FlukeyLukey77/ArduinoLEDClock/Clock Concept render.PNG

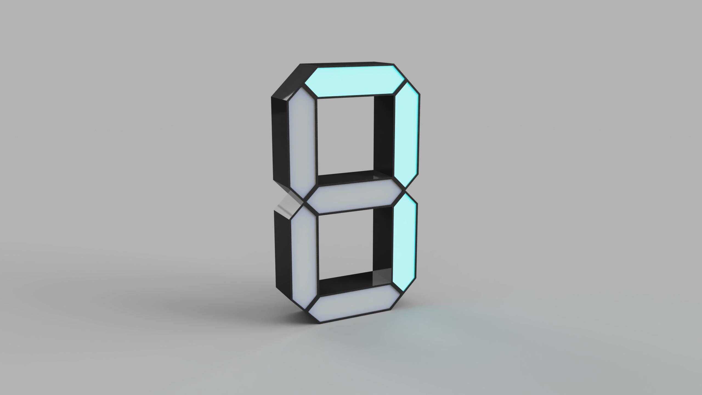
Clock Concept render.PNG
