FlukeyLukey77/ArduinoLEDClock/STLs/SegmentMain.stl

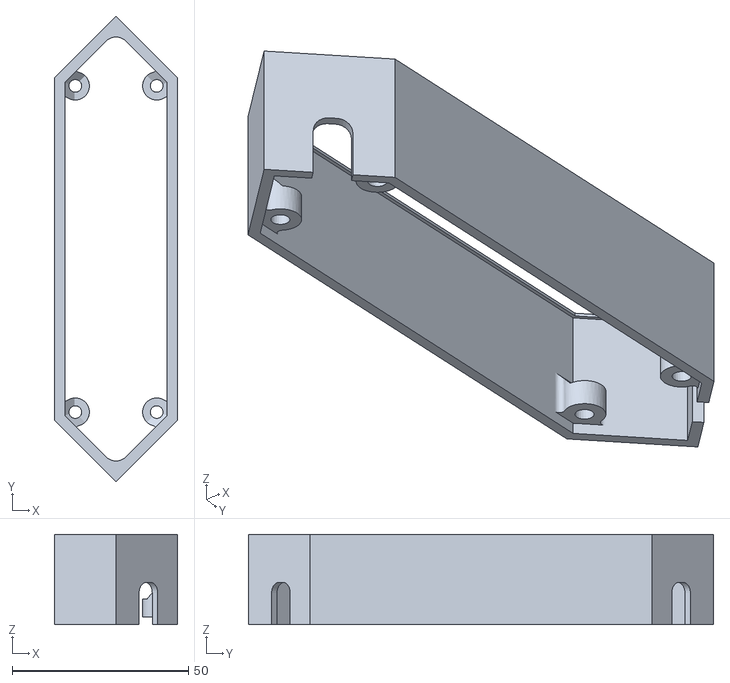
[picture p2: CAD file, 2021-03-03]
STLs/SegmentMain.stl
35.0 x 132.1 x 25.6
