FlukeyLukey77/ArduinoLEDClock/ArduinoLEDClock.step

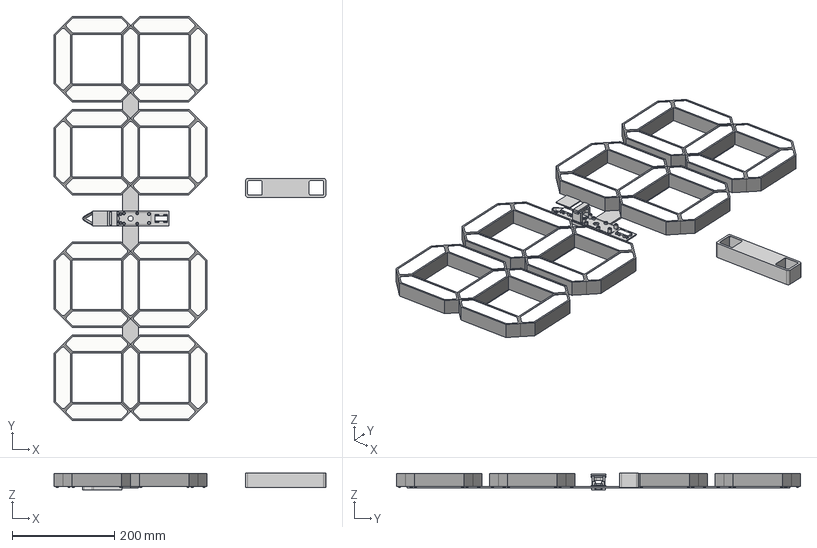
[picture p3: CAD file, 2021-03-03]
ArduinoLEDClock.step
531.9 x 791.2 x 32.4 mm
Back Plate x 24
Main Body x 24
Lens x 24
PCB (1) x 16
5050 RBG LED (1) x 48
Resistor (1) x 48
PCB (2) x 16
5050 RBG LED (2) x 48
Resistor (2) x 48
Aluminium LED Support x 24
Threaded Insert x 96
94500A262 x 96
Back Plate (1) x 4
Main Body (1) x 4
Lens (1) x 4
PCB (1) (1) x 4
5050 RBG LED (1) (1) x 12
Resistor (1) (1) x 12
PCB (2) (1) x 4
5050 RBG LED (2) (1) x 12
Resistor (2) (1) x 12
Aluminium LED Support (1) x 4
Threaded Insert (1) x 16
94500A262 (1) x 16
Steel Support
Aluminium x 2
Magnet x 2
Lens (2)
Centre Cover
Mouting hook
