FlukeyLukey77/ArduinoLEDClock/Clock PCB V2/Clock PCB.step

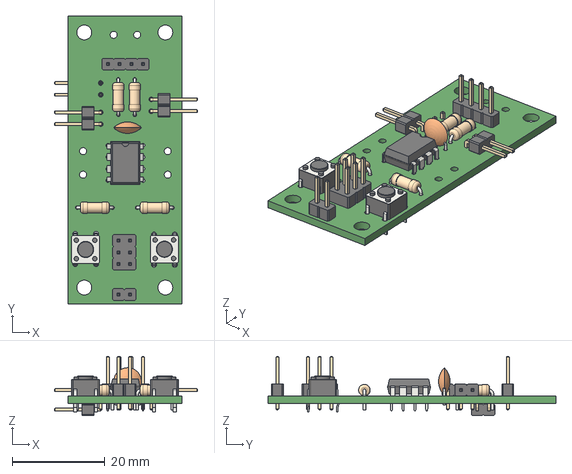
[picture p4: CAD file, 2021-03-03]
Clock PCB V2/Clock PCB.step
31.0 x 62.2 x 12.8 mm
