FlukeyLukey77/ArduinoLEDClock/STLs/CentreWallHook.stl

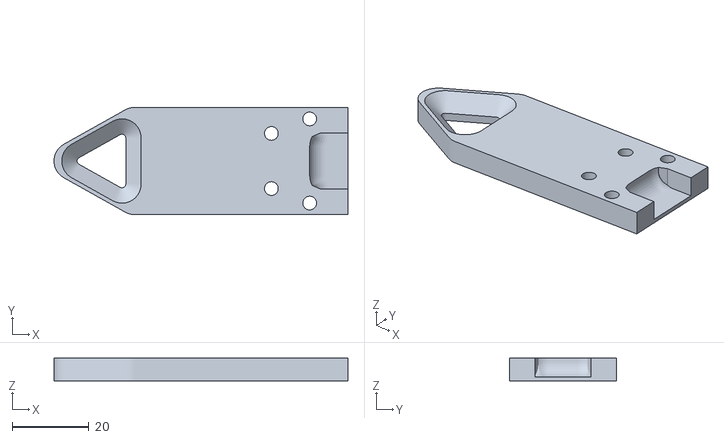
[picture p5: CAD file, 2021-03-03]
STLs/CentreWallHook.stl
76.8 x 28.0 x 6.00
