FlukeyLukey77/ArduinoLEDClock/STLs/SegmentLens.stl

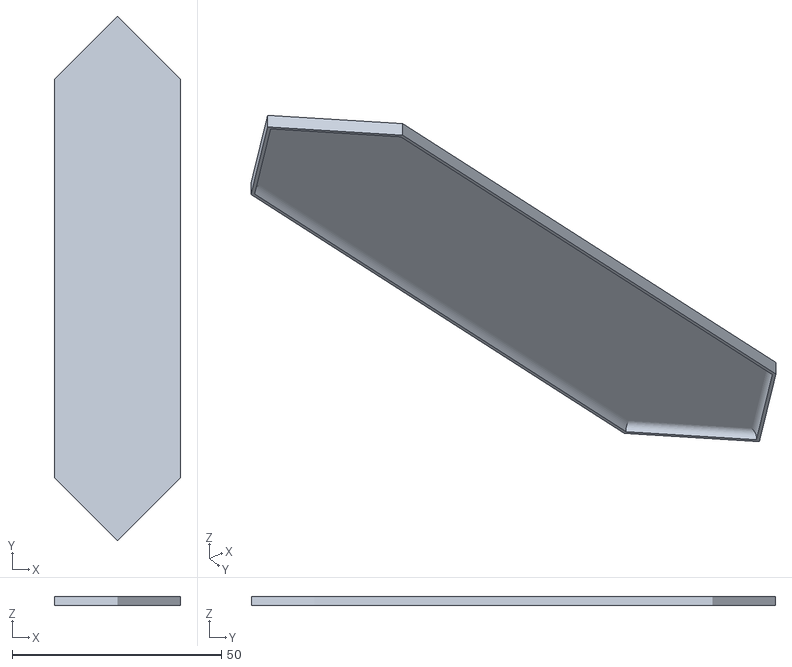
[picture p6: CAD file, 2021-03-03]
STLs/SegmentLens.stl
30.2 x 125.3 x 2.10
