FlukeyLukey77/ArduinoLEDClock/STLs/CentreCover.stl

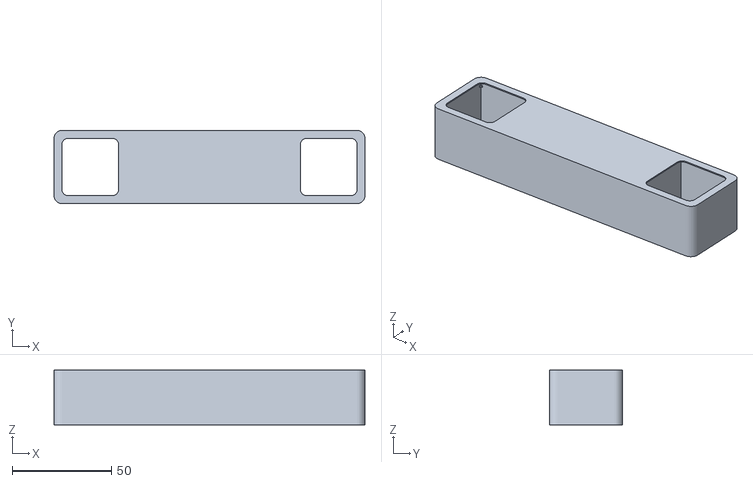
[picture p7: CAD file, 2021-03-03]
STLs/CentreCover.stl
157.0 x 37.0 x 27.6
