FlukeyLukey77/ArduinoLEDClock/STLs/CentreLens.stl

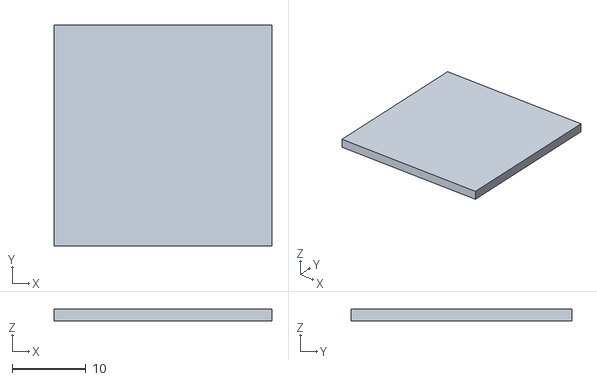
[picture p8: CAD file, 2021-03-03]
STLs/CentreLens.stl
29.6 x 30.0 x 1.60
