FlukeyLukey77/ArduinoLEDClock/STLs/CentreBack.stl

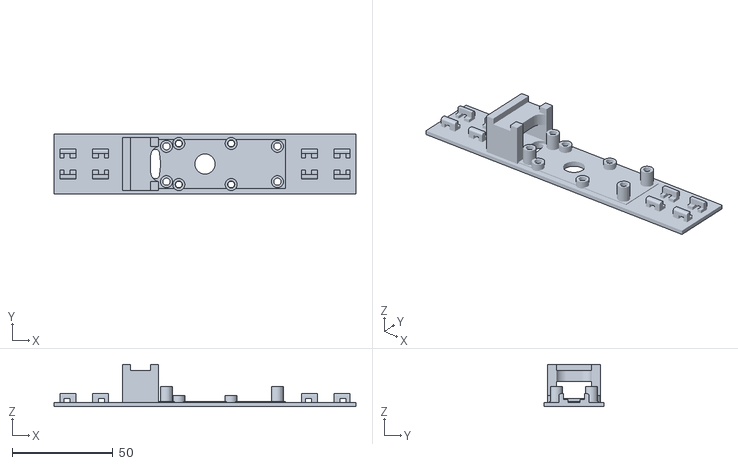
[picture p9: CAD file, 2021-03-03]
STLs/CentreBack.stl
150.0 x 30.0 x 21.1
