FlukeyLukey77/ArduinoLEDClock/STLs/SegementBack.stl

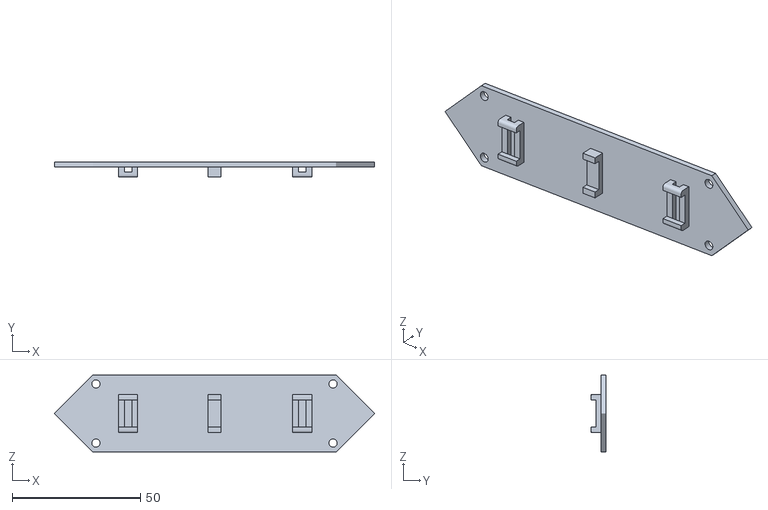
[picture p10: CAD file, 2021-03-03]
STLs/SegementBack.stl
125.0 x 6.00 x 30.0
