FlukeyLukey77/ArduinoLEDClock/Clock PCB/Clock PCB.kicad_pcb

## KiCad design Clock PCB/Clock PCB.kicad_pcb (2021-03-03)

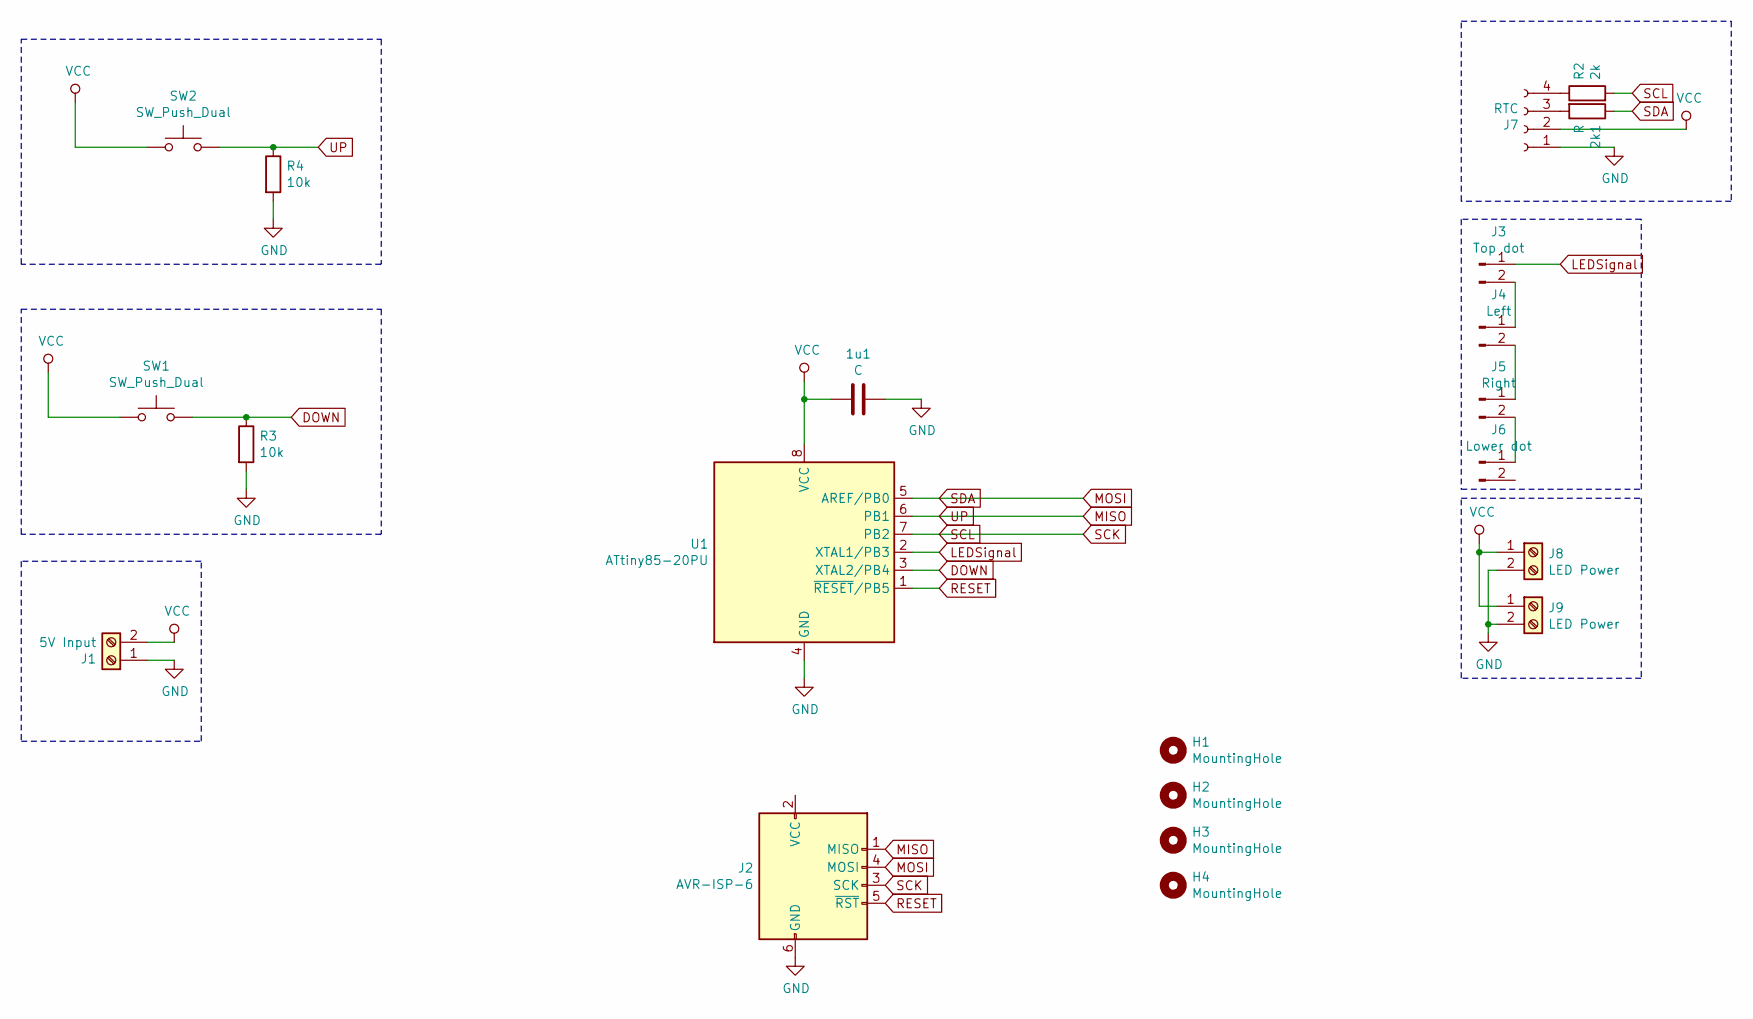
[picture p11: schematic Clock PCB.sch]

Parts:
1u1: C; C_Disc_D6.0mm_W2.5mm_P5.00mm
2k1: R; R_Axial_DIN0207_L6.3mm_D2.5mm_P7.62mm_Horizontal
H1, H2, H3, H4: MountingHole; MountingHole_3.2mm_M3
J1: 5V Input; TerminalBlock_bornier-2_P5.08mm
J2: AVR-ISP-6; PinHeader_2x03_P2.54mm_Vertical
J3: Top dot; PinHeader_1x02_P2.54mm_Horizontal
J4: Left; PinHeader_1x02_P2.54mm_Horizontal
J5: Right; PinHeader_1x02_P2.54mm_Horizontal
J6: Lower dot; PinHeader_1x02_P2.54mm_Vertical
J7: RTC; PinHeader_1x04_P2.54mm_Vertical
J8, J9: LED Power; TerminalBlock_bornier-2_P5.08mm
R2: 2k; R_Axial_DIN0207_L6.3mm_D2.5mm_P7.62mm_Horizontal
R3, R4: 10k; R_Axial_DIN0207_L6.3mm_D2.5mm_P7.62mm_Horizontal
SW1, SW2: SW_Push_Dual; SW_PUSH_6mm_H4.3mm
U1: ATtiny85-20PU; DIP-8_W7.62mm

Connections:
DOWN: R3.1, SW1.2, U1.3 (XTAL2/PB4)
GND: 1u1.1, J1.1, J2.6 (GND), J7.1, J8.2, J9.2, R3.2, R4.2, U1.4 (GND)
LEDSignal: J3.1, U1.2 (XTAL1/PB3)
MISO: J2.1 (MISO), R4.1, SW2.2, U1.6 (PB1)
MOSI: 2k1.1, J2.4 (MOSI), U1.5 (AREF/PB0)
unnamed: 2k1.2, J7.3
unnamed: J3.2, J4.1
unnamed: J4.2, J5.1
unnamed: J5.2, J6.1
unnamed: J7.4, R2.1
RESET: J2.5 (~RST), U1.1 (~RESET~/PB5)
SCK: J2.3 (SCK), R2.2, U1.7 (PB2)
VCC: 1u1.2, J1.2, J7.2, J8.1, J9.1, SW1.1, SW2.1, U1.8 (VCC)

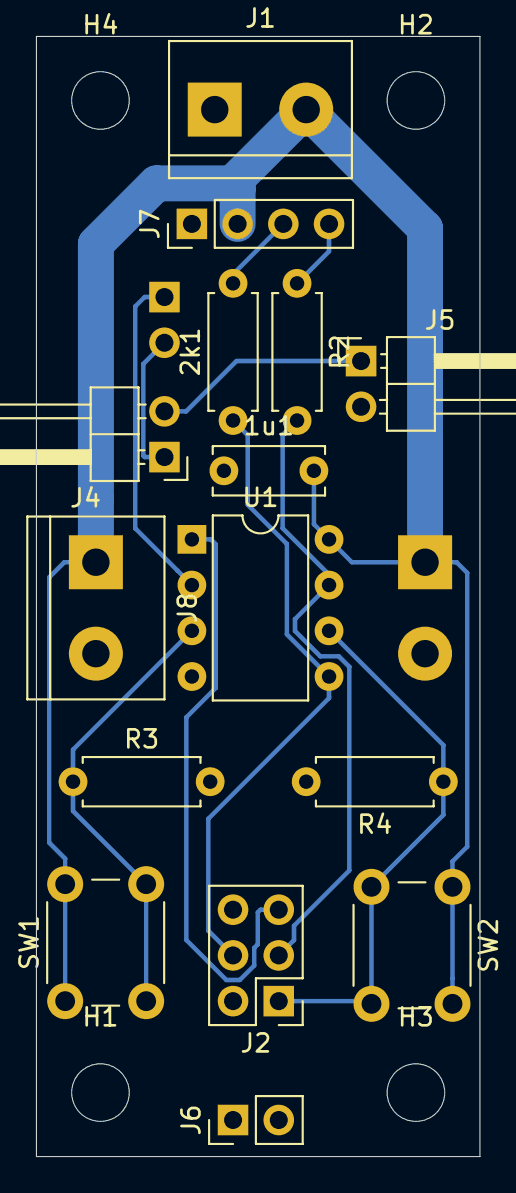
[picture p12: board Clock PCB/Clock PCB.kicad_pcb from above]

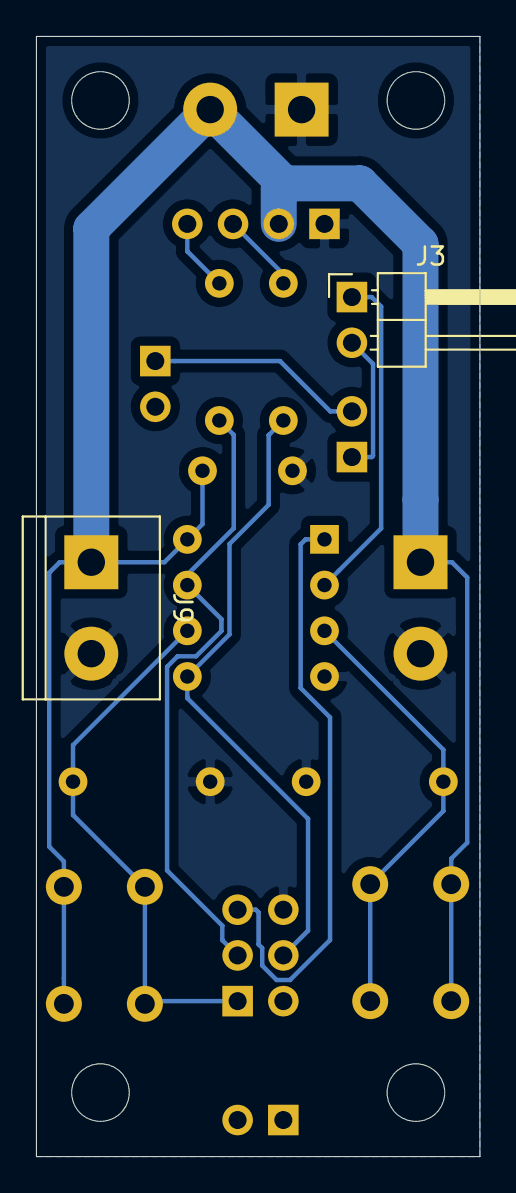
[picture p13: board Clock PCB/Clock PCB.kicad_pcb from below]

Board: 2 copper layers, 24.6 x 62.2 mm, 21 parts (2 on the bottom side), 13 nets.
