FlukeyLukey77/ArduinoLEDClock/Clock PCB V2/Clock PCB.kicad_pcb

## KiCad design Clock PCB V2/Clock PCB.kicad_pcb (2021-03-03)

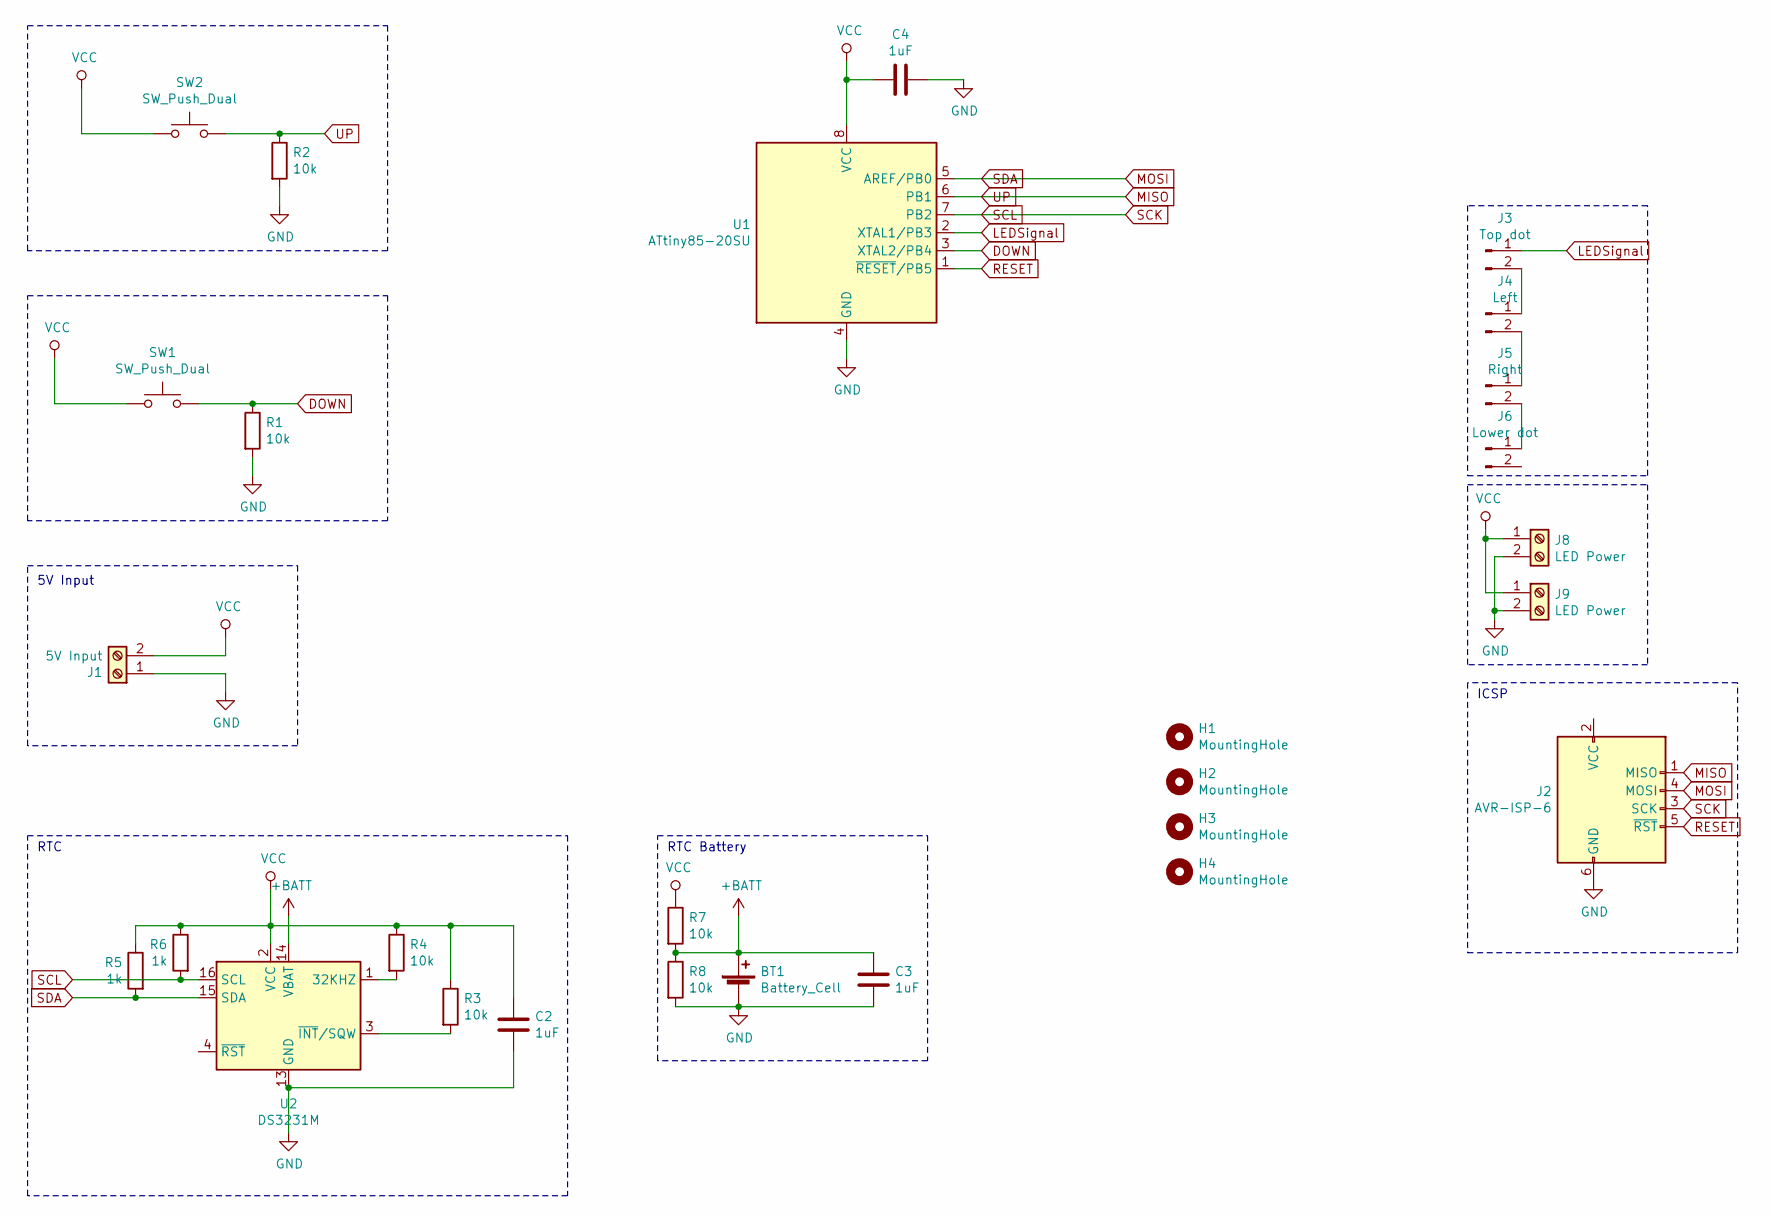
[picture p14: schematic Clock PCB.sch]

Parts:
BT1: Battery_Cell; PinHeader_1x02_P2.54mm_Horizontal
C2, C3, C4: 1uF; C_0805_2012Metric
H1, H2, H3, H4: MountingHole; MountingHole_3.2mm_M3
J1: 5V Input; TerminalBlock_bornier-2_P5.08mm
J2: AVR-ISP-6; PinHeader_2x03_P2.54mm_Vertical
J3: Top dot; PinHeader_1x02_P2.54mm_Horizontal
J4: Left; PinHeader_1x02_P2.54mm_Horizontal
J5: Right; PinHeader_1x02_P2.54mm_Horizontal
J6: Lower dot; PinHeader_1x02_P2.54mm_Horizontal
J8, J9: LED Power; TerminalBlock_bornier-2_P5.08mm
R1, R2, R3, R4, R7, R8: 10k; R_0805_2012Metric
R5, R6: 1k; R_0805_2012Metric
SW1, SW2: SW_Push_Dual; SW_PUSH_6mm_H4.3mm
U1: ATtiny85-20SU; SOIC-8_3.9x4.9mm_P1.27mm
U2: DS3231M; SOIC-16W_7.5x10.3mm_P1.27mm

Connections:
+BATT: BT1.1 (+), C3.1, R7.2, R8.1, U2.14 (VBAT)
DOWN: R1.1, SW1.2, U1.3 (XTAL2/PB4)
GND: BT1.2 (-), C2.2, C3.2, C4.1, J1.1, J2.6 (GND), J8.2, J9.2, R1.2, R2.2, R8.2, U1.4 (GND), U2.5 (GND), U2.6 (GND), U2.7 (GND), U2.8 (GND), U2.9 (GND), U2.10 (GND), U2.11 (GND), U2.12 (GND), U2.13 (GND)
LEDSignal: J3.1, U1.2 (XTAL1/PB3)
MISO: J2.1 (MISO), R2.1, SW2.2, U1.6 (PB1)
MOSI: J2.4 (MOSI), R5.2, U1.5 (AREF/PB0), U2.15 (SDA)
unnamed: J3.2, J4.1
unnamed: J4.2, J5.1
unnamed: J5.2, J6.1
unnamed: R3.2, U2.3 (~INT~/SQW)
unnamed: R4.2, U2.1 (32KHZ)
RESET: J2.5 (~RST), U1.1 (~RESET~/PB5)
SCK: J2.3 (SCK), R6.2, U1.7 (PB2), U2.16 (SCL)
VCC: C2.1, C4.2, J1.2, J8.1, J9.1, R3.1, R4.1, R5.1, R6.1, R7.1, SW1.1, SW2.1, U1.8 (VCC), U2.2 (VCC)

Notes on the sheet:
RTC
5V Input
ICSP
RTC Battery

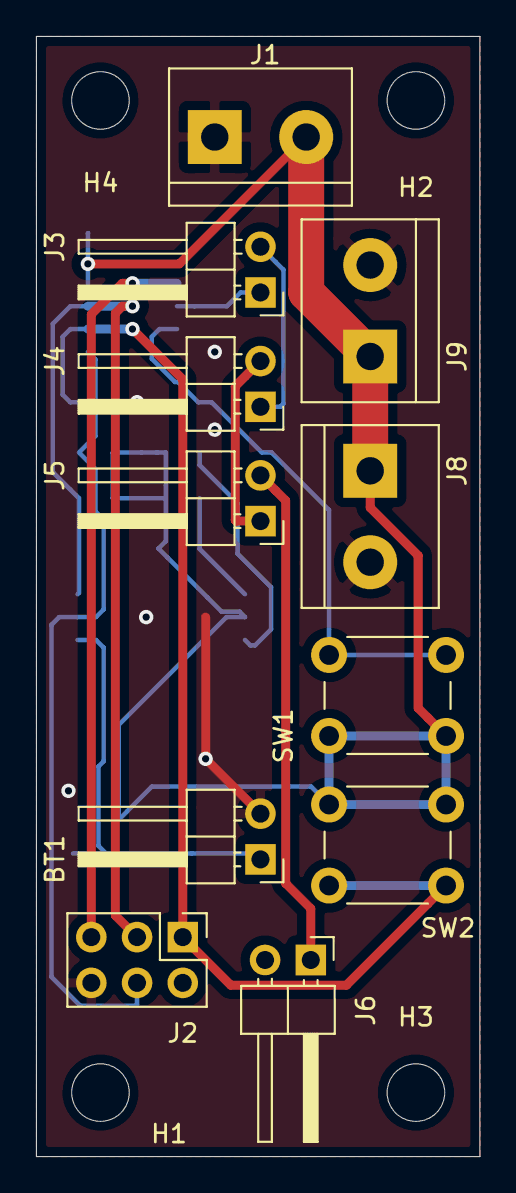
[picture p15: board Clock PCB V2/Clock PCB.kicad_pcb from above]

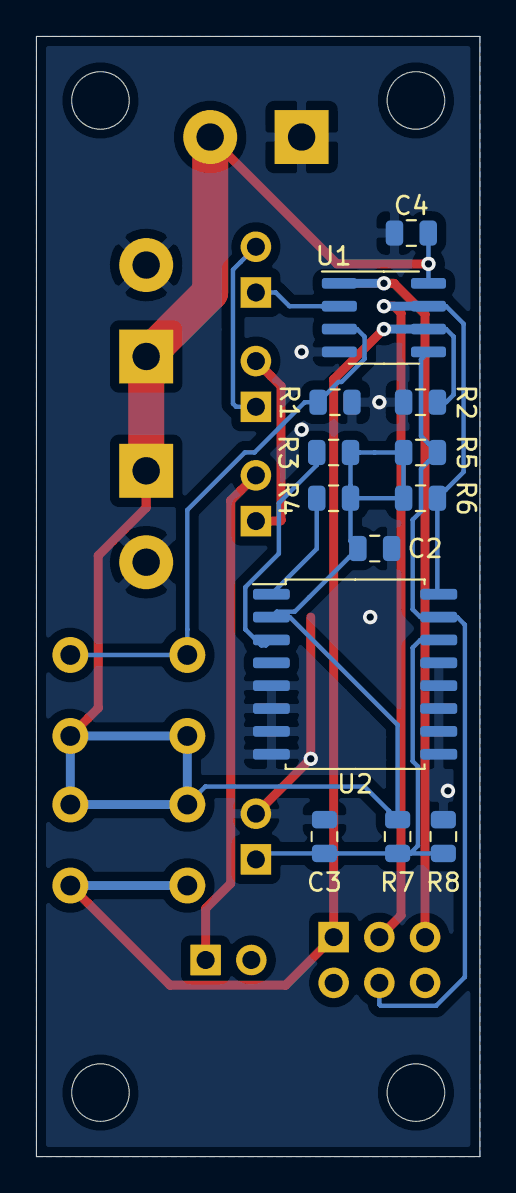
[picture p16: board Clock PCB V2/Clock PCB.kicad_pcb from below]

Board: 2 copper layers, 24.6 x 62.2 mm, 28 parts (13 on the bottom side), 14 nets.
