FlukeyLukey77/ArduinoLEDClock/LEDClockCodeV2.1/LEDFunctions.ino

/*
 * FUNCTION: displayDigit
 * INPUTS: digitNum (Integer), displayNum (Integer)
 * RETURN: none
 * PURPOSE: Takes the target digit (Integer) and a number (Integer) to print to that digit
 */
void displayDigit(uint8_t digitNum, uint8_t displayNum)
{
	switch(displayNum)
	{
		case 0:
			displaySegment(digitNum, zero);
		break;
		case 1:
			displaySegment(digitNum, one);
		break;
		case 2:
			displaySegment(digitNum, two);
		break;
		case 3:
			displaySegment(digitNum, three);
		break;
		case 4:
			displaySegment(digitNum, four);
		break;
		case 5:
			displaySegment(digitNum, five);
		break;
		case 6:
			displaySegment(digitNum, six);
		break;
		case 7:
			displaySegment(digitNum, seven);
		break;
		case 8:
			displaySegment(digitNum, eight);
		break;
		case 9:
			displaySegment(digitNum, nine);
		break;
    case 10:
      displaySegment(digitNum, off);
    break;
	}
}

/*
 * FUNCTION: displaySegment
 * INPUTS: digitNum (Integer), number[] (Integer Array)
 * RETURN: none
 * PURPOSE: Takes the target digit (Integer) and a number (Integer Array)
 * 			and displayes the desired number on the desired digit. The digit
 * 			consists of an array of booleans that tells respective segments
 * 			to switch on and off. 
 */
void displaySegment(uint8_t digitNum, uint8_t number[])
{
	/*
	 * This digit array is a temporary storage for the desired digit
	 * eg digit1 etc. This holds the start pixels for the segments. 
	 */
	int digit[7];

	/*
	 * This switch case fills the temporary array with the start values
	 * from the SEGMENT MAPPINGS. 
	 */
	switch (digitNum)
	{
		case 1: 
			for(int i = 0; i < 7; i++)
			{
				digit[i] = digit1[i];
			}
		break;
		case 2:
			for(int i = 0; i < 7; i++)
			{
				digit[i] = digit2[i];
			}
		break;
		case 3:
			for(int i = 0; i < 7; i++)
			{
				digit[i] = digit3[i];
			}
		break;
		case 4:
			for(int i = 0; i < 7; i++)
			{
				digit[i] = digit4[i];
			}
		break;
	}

	/*
	 * This section fills a buffer (Global Variable) array
	 * with boolean values telling segments to turn on or off. 
	 */
	for(int i = 0; i < 7; i++)
	{
		if(number[i] == 1)
		{
			for(int ii = 0; ii < 6; ii++)
			{
				ledBuffer[digit[i] + ii] = 1;
			}
		}
		else
		{
			for(int ii = 0; ii < 6; ii++)
			{
				ledBuffer[digit[i] + ii] = 0;
			}
		}
	}
}

/*
 * FUNCTION: displayDots
 * INPUTS: numDots (Integer)
 * RETURN: none
 * PURPOSE: Allows a single decimal dot or a colon to be shown
 */
void displayDots(uint8_t numDots)
{
	if(numDots == 1)
	{
		ledBuffer[0] = 0;
		ledBuffer[stripLength - 1] = 1;
	}
	else
	{
		ledBuffer[0] = 1;
		ledBuffer[stripLength - 1] = 1;
	}
}

/*
 * FUNCTION: displayBuffer
 * INPUTS: none
 * RETURN: none
 * PURPOSE: Takes the global array "ledBuffer" and outputs it
 * 			to the LED strip all at once. It sends the set colour
 * 			to all leds that are marked to turn on. 
 */
void displayBuffer(uint8_t numberColour[], uint8_t dotColour[])
{
	for(int i = 0; i < stripLength; i++)
	{
		if(ledBuffer[i] == 1)
		{
			if(i == 0 || i == (stripLength - 1))
			{
				cli();
				sendPixel(dotColour[0],dotColour[1],dotColour[2]);
				sei();
			}
			else
			{
				cli();
				sendPixel(numberColour[0],numberColour[1],numberColour[2]);
				sei();
			}
		}
		else
		{
			cli();
			sendPixel(0,0,0);
			sei();
		}
	}
}
/*
 * FOLLOWING CODE IS MODIFIED FROM INTERNET SOURCE
 */

/*
 This is an example of how simple driving a Neopixel can be
 This code is optimized for understandability and changability rather than raw speed
 More info at http://wp.josh.com/2014/05/11/ws2812-neopixels-made-easy/
*/

// Change this to be at least as long as your pixel string (too long will work fine, just be a little slower)

#define PIXELS stripLength  // Number of pixels in the string

// These values depend on which pin your string is connected to and what board you are using 
// More info on how to find these at http://www.arduino.cc/en/Reference/PortManipulation

// These values are for the pin that connects to the Data Input pin on the LED strip. They correspond to...

// Arduino Yun:     Digital Pin 8
// DueMilinove/UNO: Digital Pin 12
// Arduino MeagL    PWM Pin 4

// You'll need to look up the port/bit combination for other boards. 

// Note that you could also include the DigitalWriteFast header file to not need to to this lookup.

#define PIXEL_PORT  PORTB  // Port of the pin the pixels are connected to
#define PIXEL_DDR   DDRB   // Port of the pin the pixels are connected to
#define PIXEL_BIT   3      // Bit of the pin the pixels are connected to

// These are the timing constraints taken mostly from the WS2812 datasheets 
// These are chosen to be conservative and avoid problems rather than for maximum throughput 

#define T1H  900    // Width of a 1 bit in ns
#define T1L  600    // Width of a 1 bit in ns

#define T0H  400    // Width of a 0 bit in ns
#define T0L  900    // Width of a 0 bit in ns

// The reset gap can be 6000 ns, but depending on the LED strip it may have to be increased
// to values like 600000 ns. If it is too small, the pixels will show nothing most of the time.
#define RES 10000    // Width of the low gap between bits to cause a frame to latch

// Here are some convience defines for using nanoseconds specs to generate actual CPU delays

#define NS_PER_SEC (1000000000L)          // Note that this has to be SIGNED since we want to be able to check for negative values of derivatives

#define CYCLES_PER_SEC (F_CPU)

#define NS_PER_CYCLE ( NS_PER_SEC / CYCLES_PER_SEC )

#define NS_TO_CYCLES(n) ( (n) / NS_PER_CYCLE )

// Actually send a bit to the string. We must to drop to asm to enusre that the complier does
// not reorder things and make it so the delay happens in the wrong place.

inline void sendBit( bool bitVal ) {
  
    if (  bitVal ) {        // 0 bit
      
    asm volatile (
      "sbi %[port], %[bit] \n\t"        // Set the output bit
      ".rept %[onCycles] \n\t"                                // Execute NOPs to delay exactly the specified number of cycles
      "nop \n\t"
      ".endr \n\t"
      "cbi %[port], %[bit] \n\t"                              // Clear the output bit
      ".rept %[offCycles] \n\t"                               // Execute NOPs to delay exactly the specified number of cycles
      "nop \n\t"
      ".endr \n\t"
      ::
      [port]    "I" (_SFR_IO_ADDR(PIXEL_PORT)),
      [bit]   "I" (PIXEL_BIT),
      [onCycles]  "I" (NS_TO_CYCLES(T1H) - 2),    // 1-bit width less overhead  for the actual bit setting, note that this delay could be longer and everything would still work
      [offCycles]   "I" (NS_TO_CYCLES(T1L) - 2)     // Minimum interbit delay. Note that we probably don't need this at all since the loop overhead will be enough, but here for correctness

    );
                                  
    } else {          // 1 bit

    // **************************************************************************
    // This line is really the only tight goldilocks timing in the whole program!
    // **************************************************************************


    asm volatile (
      "sbi %[port], %[bit] \n\t"        // Set the output bit
      ".rept %[onCycles] \n\t"        // Now timing actually matters. The 0-bit must be long enough to be detected but not too long or it will be a 1-bit
      "nop \n\t"                                              // Execute NOPs to delay exactly the specified number of cycles
      ".endr \n\t"
      "cbi %[port], %[bit] \n\t"                              // Clear the output bit
      ".rept %[offCycles] \n\t"                               // Execute NOPs to delay exactly the specified number of cycles
      "nop \n\t"
      ".endr \n\t"
      ::
      [port]    "I" (_SFR_IO_ADDR(PIXEL_PORT)),
      [bit]   "I" (PIXEL_BIT),
      [onCycles]  "I" (NS_TO_CYCLES(T0H) - 2),
      [offCycles] "I" (NS_TO_CYCLES(T0L) - 2)

    );
      
    }
    
    // Note that the inter-bit gap can be as long as you want as long as it doesn't exceed the 5us reset timeout (which is A long time)
    // Here I have been generous and not tried to squeeze the gap tight but instead erred on the side of lots of extra time.
    // This has thenice side effect of avoid glitches on very long strings becuase 

    
}  

  
inline void sendByte( unsigned char byte ) {
    
    for( unsigned char bit = 0 ; bit < 8 ; bit++ ) {
      
      sendBit( bitRead( byte , 7 ) );                // Neopixel wants bit in highest-to-lowest order
                                                     // so send highest bit (bit #7 in an 8-bit byte since they start at 0)
      byte <<= 1;                                    // and then shift left so bit 6 moves into 7, 5 moves into 6, etc
      
    }           
} 

/*
  The following three functions are the public API:
  
  ledSetup() - set up the pin that is connected to the string. Call once at the begining of the program.  
  sendPixel( r g , b ) - send a single pixel to the string. Call this once for each pixel in a frame.
  show() - show the recently sent pixel on the LEDs . Call once per frame. 
  
*/


// Set the specified pin up as digital out

void ledsetup() {
  
  bitSet( PIXEL_DDR , PIXEL_BIT );
  
}

inline void sendPixel( unsigned char r, unsigned char g , unsigned char b )  {  
  
  sendByte(g);          // Neopixel wants colors in green then red then blue order
  sendByte(r);
  sendByte(b);
  
}


// Just wait long enough without sending any bots to cause the pixels to latch and display the last sent frame

void show() {
  _delay_us( (RES / 1000UL) + 1);       // Round up since the delay must be _at_least_ this long (too short might not work, too long not a problem)
}


/*
  That is the whole API. What follows are some demo functions rewriten from the AdaFruit strandtest code...
  
  https://github.com/adafruit/Adafruit_NeoPixel/blob/master/examples/strandtest/strandtest.ino
  
  Note that we always turn off interrupts while we are sending pixels becuase an interupt
  could happen just when we were in the middle of somehting time sensitive.
  
  If we wanted to minimize the time interrupts were off, we could instead 
  could get away with only turning off interrupts just for the very brief moment 
  when we are actually sending a 0 bit (~1us), as long as we were sure that the total time 
  taken by any interrupts + the time in our pixel generation code never exceeded the reset time (5us).
  
*/
